machadevrepos/Smart_hydration_Band/Docs/Umbra_Firmware_Overview_and_Status_Report.docx

Umbra Smart Hydration Wristband: Firmware Overview and Status Report

6th Nov 2026

1. Purpose

This report describes how the Umbra wristband firmware (version 1.0.0) works, what it delivers against the project requirements, and what has been tested so far.

2. Platform

- Processor: BMD-350-A-R module (Nordic nRF52832) with Bluetooth Low Energy.
- Software: nRF Connect SDK v3.3.1 (Zephyr RTOS). The firmware is built for the nrf52dk/nrf52832 target with a board overlay that describes the Umbra PCB.
- Sensors: MAX30101 optical sensor for heart rate and BMI270 motion sensor for steps, both on one I2C bus.
- Outputs and input: a vibration motor, a WS2812 RGB status LED and one push button.
- Battery: a LiPo cell; the firmware measures its voltage through a resistor divider.
- Firmware version: 1.0.0, shown at start-up and readable over Bluetooth.

3. Standalone Operation

The band works completely on its own, out of the box, with no app, pairing or setup, according to the requirement. Bluetooth and the app add live data and settings, but the water reminders never depend on them.

- Daily Mode at power-up: white LED, reminder every 90 minutes.
- Night Mode: started and ended by pressing the button on the band. One buzz confirms each press. Green LED, reminder every 35 minutes.
- Reminder pattern: a double tap, two short firm pulses (200 ms on, 200 ms off, 200 ms on).
- LED: solid colour showing the current mode, with no breathing or fading, as the client asked.
- Reminders keep firing whether or not a phone is connected, and even if a sensor fails.

4. Control from the App

The app can control the band over Bluetooth. Every setting below is checked by the band, and values outside the allowed range are rejected.

- Mode: the app can switch between Daily and Night Mode. The band responds exactly as to a button press (LED, one buzz, the interval starts over) and reports every mode change, including those made with the button.
- Reminder intervals: the app can set the Daily and Night intervals from 1 to 240 minutes (the app offers 20, 30, 45 and 60). They are saved in the band's flash memory and kept through power-off. A value of 0 restores the default.
- Quiet hours: Daily Mode reminders are skipped from 23:00 to 07:00 local time. Night Mode always buzzes, because a night out runs through these hours. The app can change the window or turn it off; the setting is kept in flash.
- Time of day: the app sends the time and time zone on each connection. The band needs it for quiet hours and to timestamp its history.
- Buzz command: the app can make the band give its reminder double tap, for example for a test or a demo. At most one command every 2 seconds is accepted.
- Live data: heart rate (standard Bluetooth Heart Rate Service), battery level, step count and mode, plus the firmware version.

The full interface, with every value's byte layout and the sequence the app should follow on each connection, is documented for the app developer in BLE_INTERFACE.md.

5. Sensing

5.1 Heart rate

- The MAX30101 infrared LED is sampled 100 times per second. Infrared is used because the green LED cannot run from the board's 3.3 V LED supply.
- The band detects skin contact from the light level. The first reading comes about 11 seconds after the band is put on, then one reading every second.
- The algorithm filters the signal (0.9–3 Hz), measures the dominant rhythm over the last 8 seconds (40–200 bpm), rejects weak or irregular signals, removes bursts caused by movement, and holds the last value for up to 5 seconds through a short bad stretch. When there is no reliable pulse it reports "no reading" rather than a wrong value.
- The sensor's own sampling clock was found to run about 5% fast, so the firmware measures it and corrects every reading.
- On earlier tests at rest on the wrist it gave steady readings of 82–87 bpm. Accuracy has not yet been measured against a reference device, and arm movement is not compensated.

5.2 Steps

- The BMI270's built-in step counter counts the steps; the firmware reads it once a second. The live count starts from zero at each power-on. Step history is kept in the log (Section 6).

5.3 Battery

- The battery voltage is measured every 10 seconds and converted to a percentage using a typical LiPo curve. The reading has not yet been calibrated against a meter.

6. Data Logging and Sync

Steps and heart rate are stored in the band's flash memory all the time, so nothing is lost while the phone is away, and they are sent to the app automatically when it connects.

- One record per period: 5 minutes in Daily Mode and 1 minute in Night Mode. Each record holds the start time, the steps in the period, the average and highest heart rate, and the mode.
- Capacity: 1024 records, about 3.5 days of Daily Mode or 17 hours of Night Mode. When it is full the oldest record is replaced. The history survives power-off and an empty battery.
- Sync: each record has a number that only increases. On every connection the app asks for everything after the last record it has, receives them, and then an end marker. A dropped connection loses nothing; the next sync starts again from the same point.
- Time stamps: the band has no battery-backed clock. Records made after a power-on but before the app sets the time are given their real time as soon as the time is known, provided the band has not been switched off in between; otherwise they are marked as having no real time.
- The record in progress is saved before the band switches itself off on a flat battery.

7. Reliability Features

- Sensor failures do not stop the band: whether the heart-rate sensor fails at start-up or stops answering later, the reminders, button, LED and Bluetooth keep running. If it stops answering later, heart rate resumes on its own when the sensor recovers; if it fails at start-up, heart rate stays off until the next power-on. If the sensor resets itself, its settings are written back automatically.
- Hardware watchdog: if the firmware ever stops responding for 10 seconds, the band restarts itself instead of staying silent.
- Resume after a restart: after such a restart the band returns to the same mode, the same reminder schedule and the same time of day, so a Night session is not interrupted.
- Bluetooth recovery: if advertising cannot restart after a disconnection, the band retries every 5 seconds, so the app can always reconnect without a power cycle.
- Low-battery protection: below 3.3 V (less than about 5% left) for one minute, the band saves its history, turns off the motor, LED and sensors and switches off, to protect the battery and avoid erratic behaviour. A button press wakes it after charging.
- Diagnostics: at start-up the band reports its firmware version and the reason for the last restart over the debug connection.

8. Power Consumption

- Measured: about 9–10 mA on average, with brief peaks of about 70 mA while the motor runs.
- Estimated battery life: about 25–28 hours on a 300 mAh cell, or about 45 hours on 500 mAh. The motor reminders add less than 0.1% to the average. This meets the 14-hour Daily Mode and 6-hour Night Mode needs.
- Power saving in this version: the processor sleeps between tasks, the band asks the phone for a slow connection interval (200–400 ms), and it switches itself off on a flat battery.
- Possible further savings: measuring heart rate in short bursts in Daily Mode (the client's 5-minute sampling plan), turning the sensor off when the band is not worn, slower Bluetooth advertising, and a dimmer or timed LED. Together these could bring the average to roughly 3–4 mA (estimated). Changing the LED behaviour needs the client's approval.

9. Requirements Coverage

Delivered in this version:

- Standalone reminders with no app or pairing; Daily and Night Mode with the requested defaults.
- Button to start and end a Night session, with a confirming buzz.
- Mode LED (white for Daily, green for Night, solid).
- Double-tap haptic pattern; haptic command from the app.
- Mode and reminder intervals set from the app and stored on the band.
- Quiet hours from 23:00 to 07:00 in Daily Mode.
- Live heart rate, steps and battery level over Bluetooth.
- Steps and heart rate stored in flash while disconnected and synced on reconnection.
- Reminders continue when Bluetooth drops.
- Firmware version reporting, watchdog recovery and low-battery protection.

Not delivered in this version (client agreement needed):

- SpO2, heart rate variability, respiration rate, full PPG waveform capture, skin temperature (no sensor on the board) and sleep detection.

10. Test Status

Confirmed on the prototype:

- The button, both LED colours and the motor patterns, running on battery.
- Average current consumption and motor peak current.
- Heart rate at rest on the wrist and the step counter responding to movement.

Umbra Smart Hydration Wristband
