machadevrepos/Smart_hydration_Band/Docs/AppLandingScreenMockUp.jpeg

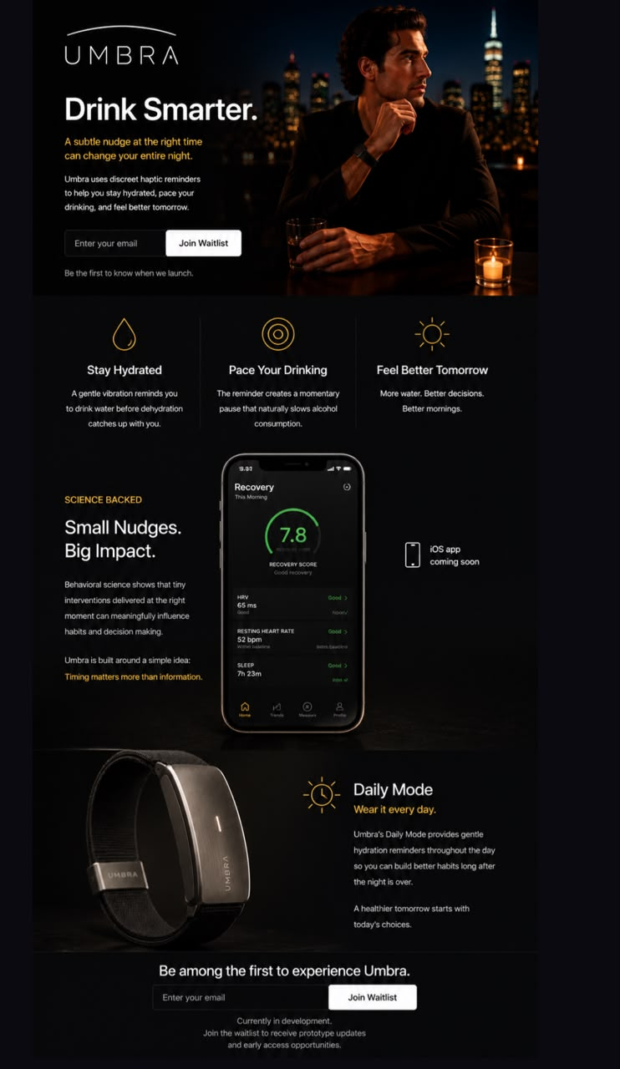
Docs/AppLandingScreenMockUp.jpeg
