machadevrepos/Smart_hydration_Band/Docs/query1ans.jpeg

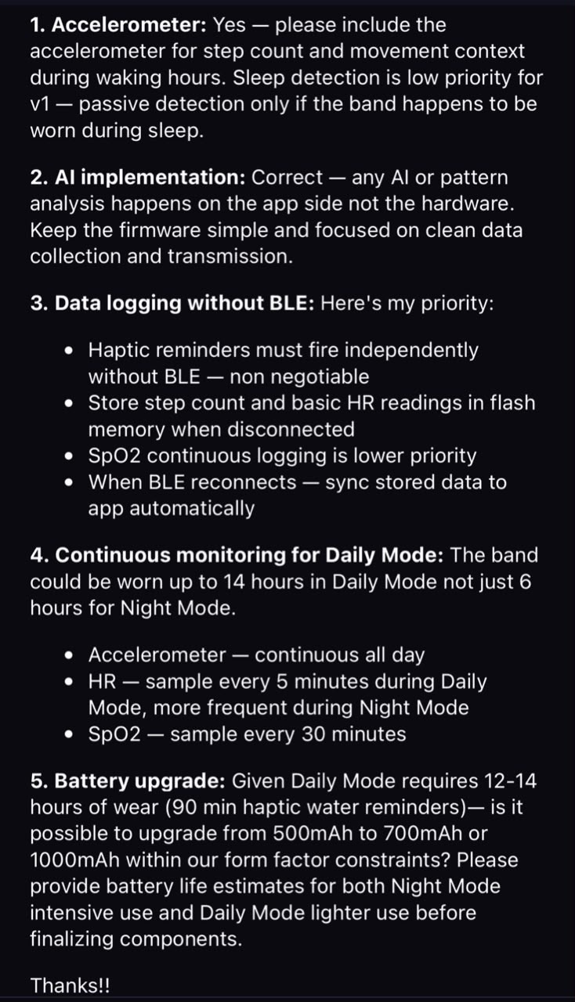
Docs/query1ans.jpeg
