machadevrepos/Smart_hydration_Band/Docs/Query2.jpeg

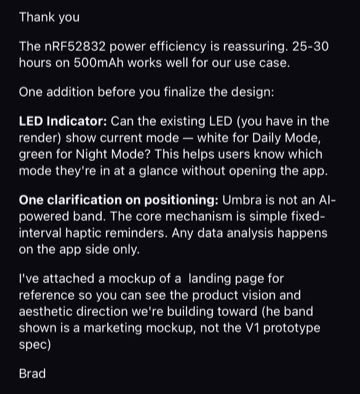
Docs/Query2.jpeg
