machadevrepos/Smart_hydration_Band/Docs/WhatsApp Image 2026-10-29 at 2.35.52 PM.jpeg

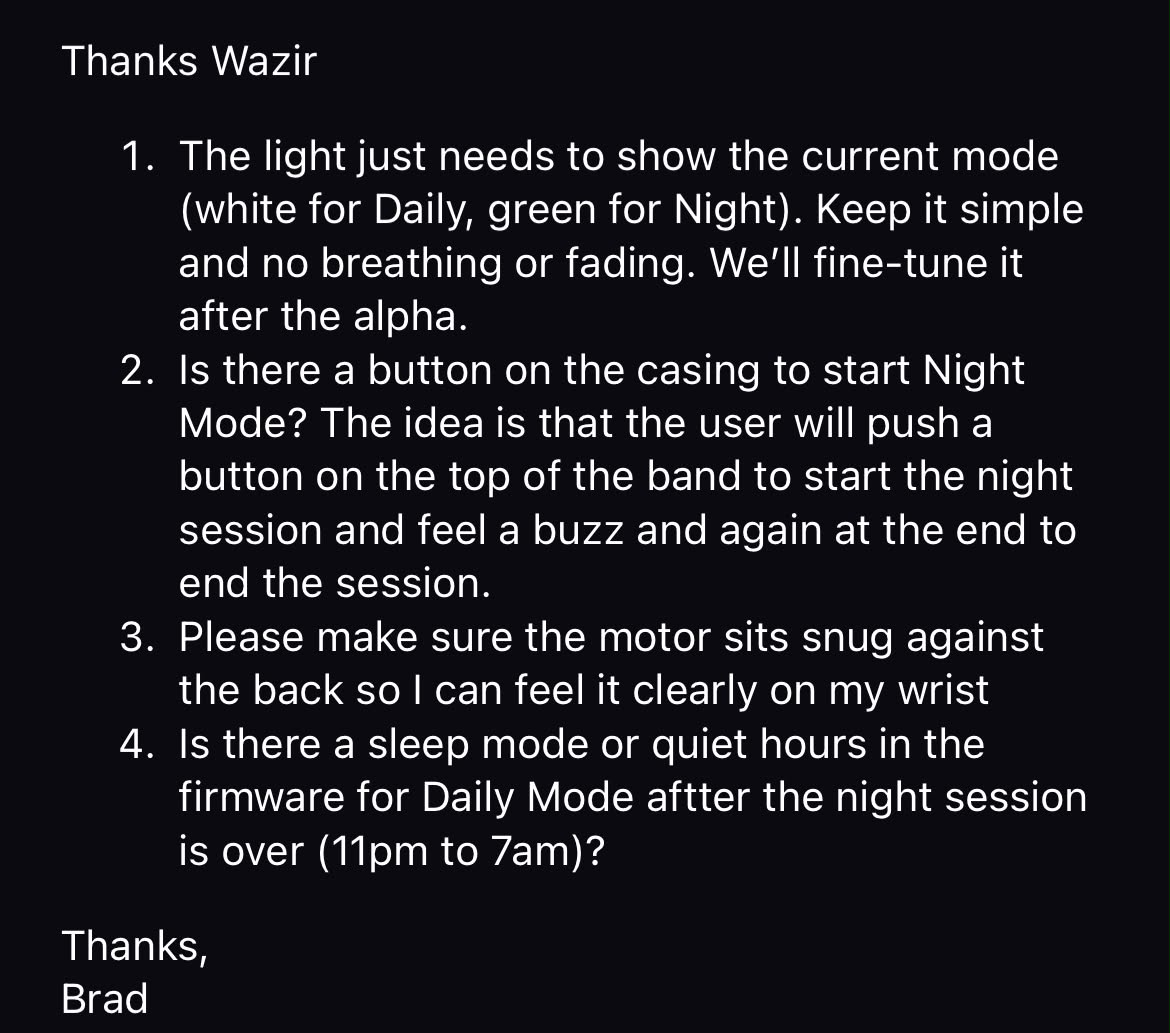
Docs/WhatsApp Image 2026-10-29 at 2.35.52 PM.jpeg
