machadevrepos/Smart_hydration_Band/PCB/kicad_project/project1.step

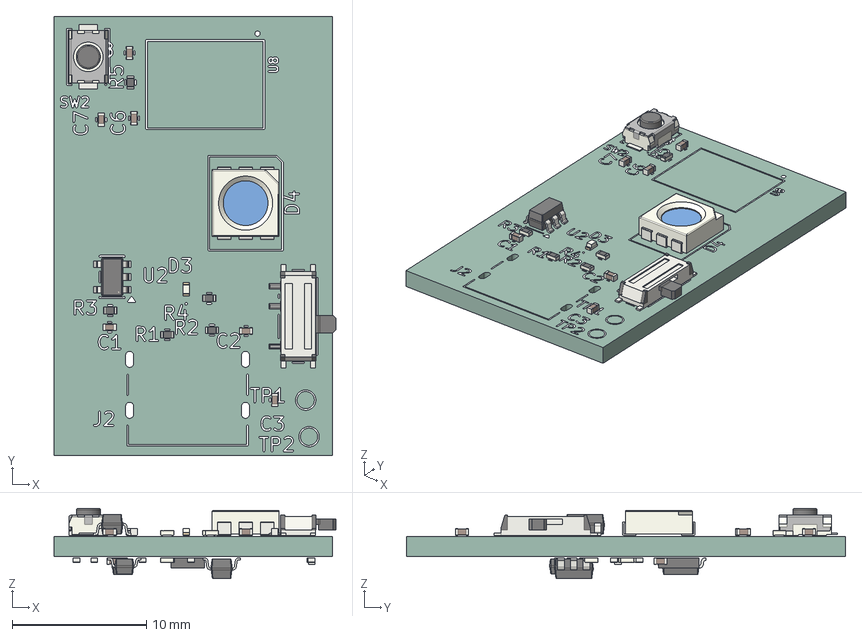
[picture p5: CAD file, 2026-10-29]
PCB/kicad_project/project1.step
21.0 x 32.7 x 5.23 mm
R_0402_1005Metric x 13
C_0402_1005Metric x 8
SOT-23-5 x 2
LED_0402_1005Metric
Fusion_sp
LED_WS2812_PLCC6_50x50mm_P16mm
SW_Push_SPST_NO_Alps_SKRK
D_SOD-123
Bosch_LGA_14_3x25mm_P05mm
SOT-23
proA5D3_silkscreen x 2
proA5D3_PCB
