machadevrepos/Smart_hydration_Band/Docs/Umbra_Hardware_and_Project_Issues_Report.docx

Umbra Smart Hydration Wristband: Hardware and Project Issues Report

6th Nov 2026

1. Purpose

This report records the hardware, PCB and project-level issues found during firmware development, board bring-up and the final pre-delivery review of the Umbra prototype. For each issue it states what was found, why it matters, the recommended fix and its current status, so that the changes made before delivery can be decided with full information.
2. Summary of Priorities

The following items must be resolved, or agreed with the client, before the prototype is shipped:

- MAX30101 supply voltage: the sensor's 1.8 V analog supply is connected to 3.3 V on the schematic. According to the datasheet it should be 1.8V and maximum can be 2.2V.
- Requirements not delivered in this version: SpO2 and several derived metrics need the client's agreement to be deferred.

3. PCB and Hardware Issues

3.1 MAX30101 analog supply above its absolute maximum (Critical)

- Finding: the MAX30101 has a separate 1.8 V analog supply (VDD, pin 11; operating range 1.7–2.0 V, absolute maximum 2.2 V) and an LED supply (VLED+, pins 9–10; 3.1–5.0 V). The schematic connects pin 11 to +3.3 V together with VLED+. The only regulator on the board is the AP2112K-3.3, so there is no 1.8 V rail.
- Impact: 3.3 V is 1.1 V above the absolute maximum. The sensor may work on the bench and then drift, give unreliable readings or fail permanently in use. Firmware cannot detect or correct this. If the sensor fails, the water reminders continue but heart rate is lost.

3.2 Green LED cannot run from the 3.3 V LED supply

- Finding: the MAX30101 green LED needs 4.5–5.5 V on VLED+, while red and IR need 3.1–5.0 V. VLED+ is 3.3 V. On the first board the green channel read about 16,000 counts on a fingertip and 6,000 on the wrist, with no usable pulse.
- Impact: wrist wearables normally use green light because it gives the strongest pulse at the wrist. This board uses the infrared LED instead. Infrared works at rest, but the wrist pulse is small (about 40–70 counts on a level of about 172,000) and depends on how the band sits, which limits heart-rate robustness, especially during movement.

3.3 Supply drop during motor pulses (Major, partly resolved)

- Finding: the board draws a peak of about 70 mA while the motor runs. When the board was powered from the J-Link, the 3.3 V rail dropped during each pulse and the processor reset, so the band restarted in Daily Mode. Powered from the battery, it works correctly.
- Impact: near the end of the battery the regulator has less headroom, and the same drop could reset the band at every reminder.
- Recommended fix: run the band from a bench supply at 3.4–3.5 V and trigger reminders. If it resets, add bulk capacitance near the motor and the regulator, or power the motor from the battery line instead of 3.3 V.

3.4 Status LED powered below its rated voltage (Minor)

- Finding: the WS2812 RGB LED is rated for 3.5–5.3 V and is powered from 3.3 V.
- Impact: it works on this board, but colour and brightness may vary between parts and with temperature.

3.5 Status LED draws current even when off (Minor)

- Finding: the LED's built-in controller is powered permanently from 3.3 V and draws about 1 mA even when dark. When lit white it is the largest single load on the board (about 6 mA, estimated).
- Impact: after the firmware switches the band off on a flat battery, the battery keeps draining slowly. It also shortens battery life in normal use.

3.6 BMI270 CSB pin has no pull-up (Minor)

- Finding: the BMI270 selects I2C or SPI from its CSB pin (P0.23), which has no pull-up on the PCB.
- Impact: the pin floats until the firmware drives it, which could select the wrong interface.

3.7 No low-frequency crystal

- Finding: the BMD-350 module has no 32.768 kHz crystal, so the firmware uses the internal RC oscillator (±500 ppm).
- Impact: the band's clock drifts by up to about 45 seconds per day. This is acceptable because the app sets the time on every connection.

3.7 No skin temperature sensor.

- Finding: the board has no skin temperature sensor, so this requirement cannot be met on the current hardware.
- Status: needs a hardware change if the requirement stays.

4. Project and Requirement Issues

The following client requirements are not delivered in the current firmware, or depend on something outside the band. They need the client's agreement before shipping.

- SpO2: not implemented. It is listed in Milestone 1 (sensors reading heart rate and SpO2). It needs the red LED alongside infrared, and SpO2 measured at the wrist is difficult; accuracy would have to be validated against a reference oximeter. Proposed for the next phase.
- Heart rate variability and respiration rate: not implemented. Both need reliable beat-to-beat timing, which the infrared wrist signal does not yet provide.
- Full PPG waveform capture: not implemented. Streaming the raw 100 samples per second over Bluetooth costs power and needs support in the app.
- Skin temperature: no sensor on the board.
- Sleep detection: not implemented (marked low priority for version 1 by the client).
- Low-power sampling plan: the requested plan (heart rate every 5 minutes in Daily Mode, SpO2 every 30 minutes) is not implemented; heart rate is measured continuously. Battery life still meets the 14-hour need, and the plan can be added later.
- Heart-rate accuracy: readings are steady at rest, but they have not been compared with a reference device (chest strap or ECG), and arm movement is not compensated.
- Quiet hours depend on the phone's time: the band has no battery-backed clock. After a power-on, until the app connects and sets the time, there are no quiet hours and the band buzzes through the night.
- Reminders off the wrist: the band buzzes on schedule even when it is not worn, for example on a nightstand.
- Open Bluetooth link: as required, there is no pairing. Any phone nearby can connect, one at a time, and trigger a buzz; the band accepts at most one buzz command every 2 seconds.
- Live step count restarts at power-on: the step history is kept in the band's flash log and synced to the app.

Umbra Smart Hydration Wristband
