machadevrepos/Smart_hydration_Band/PCB/Schematic.pdf

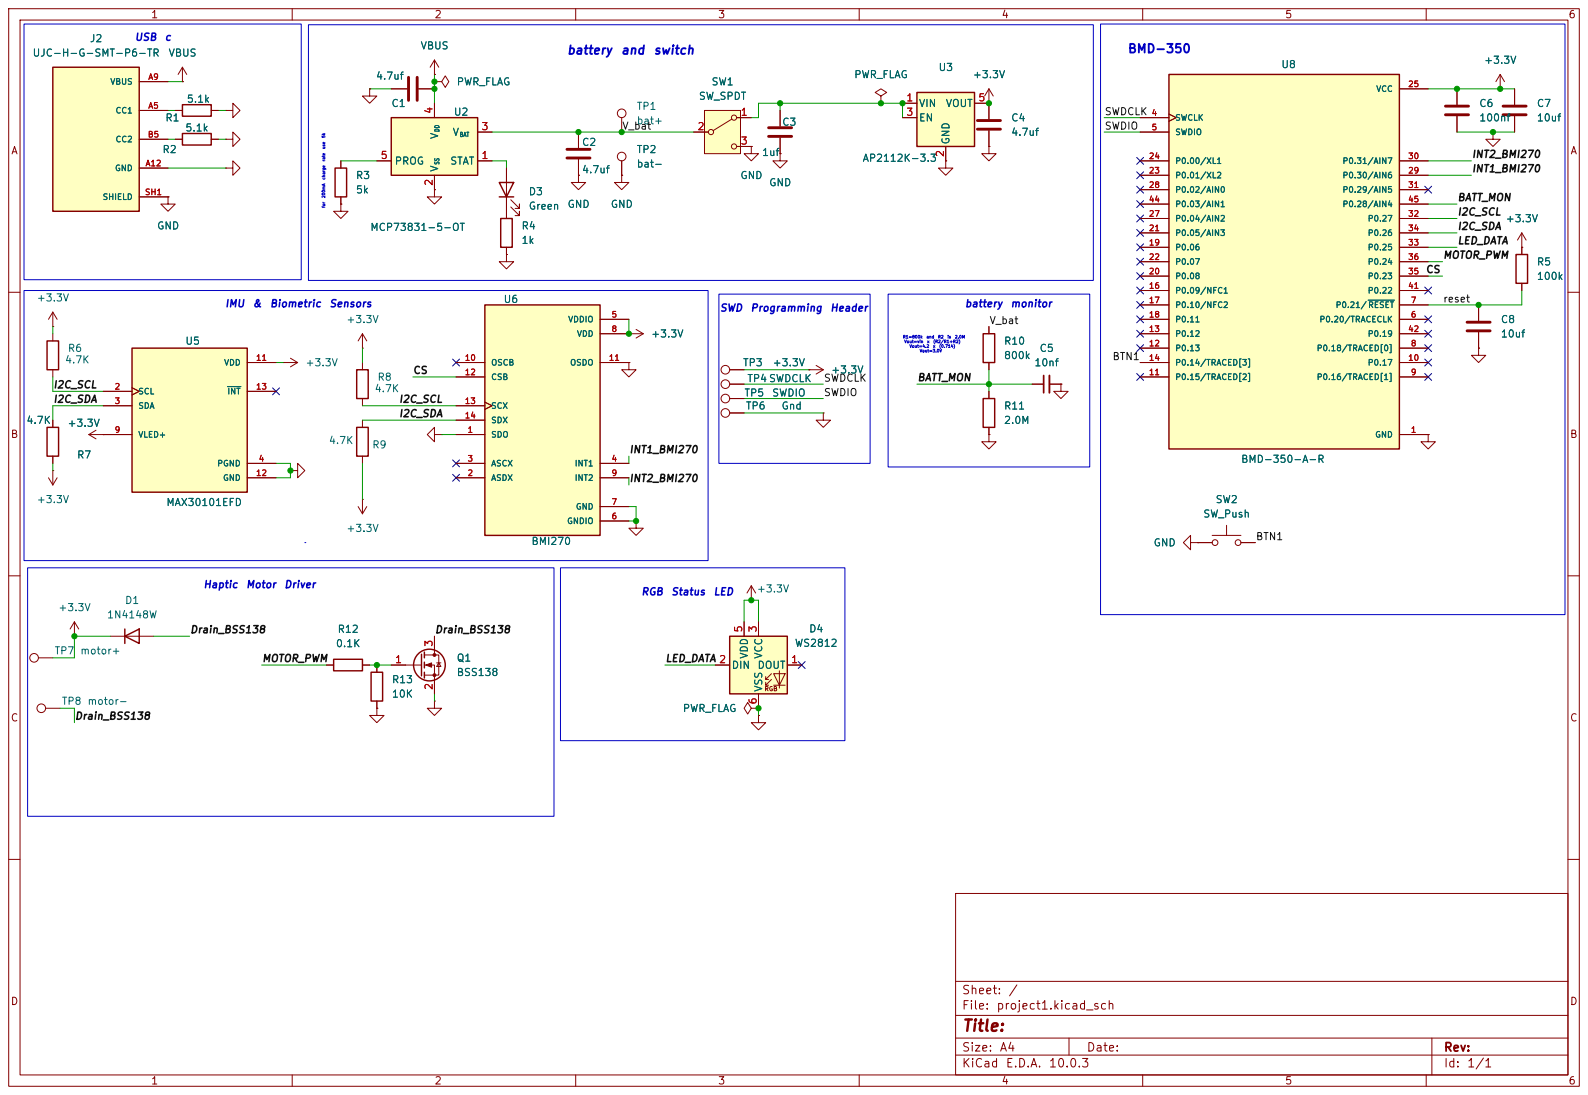
[picture p6: page 1]

Size: A4 | Rev:
KiCad E.D.A. 10.0.3 | Id: 1/1
