machadevrepos/Smart_hydration_Band/PCB/kicad_project/project1.kicad_pcb

## KiCad design PCB/kicad_project/project1.kicad_pcb (2026-10-29)

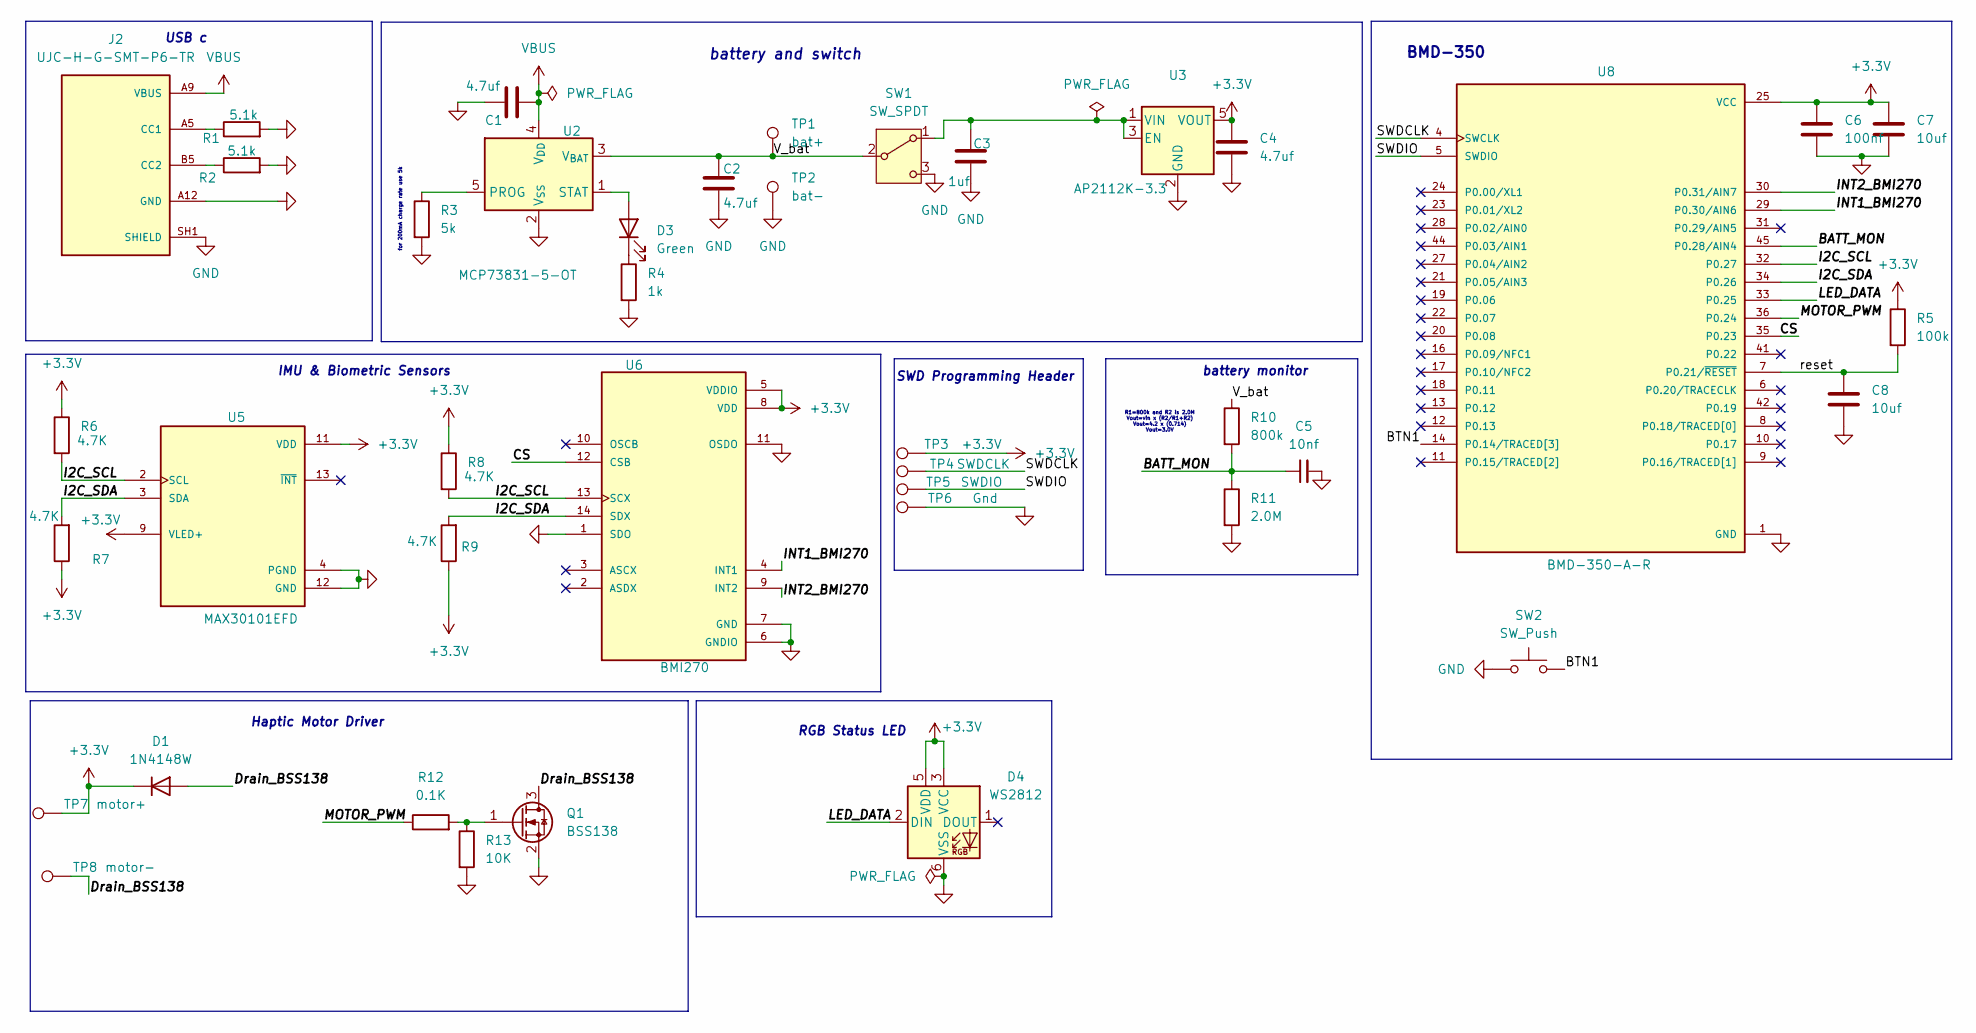
[picture p7: schematic project1.kicad_sch]

Parts:
C1, C2, C4: 4.7uf; C_0402_1005Metric
C3: 1uf; C_0402_1005Metric
C5: 10nf; C_0402_1005Metric
C6: 100nf; C_0402_1005Metric
C7, C8: 10uf; C_0402_1005Metric
D1: 1N4148W; D_SOD-123
D3: Green; LED_0402_1005Metric
D4: WS2812; LED_WS2812_PLCC6_5.0x5.0mm_P1.6mm
J2: UJC-H-G-SMT-P6-TR; SAMESKY_UJC-H-G-SMT-P6-TR; PARTREV 1.0
Q1: BSS138; SOT-23
R1, R2: 5.1k; R_0402_1005Metric
R3: 5k; R_0402_1005Metric
R4: 1k; R_0402_1005Metric
R5: 100k; R_0402_1005Metric
R6, R7, R8, R9: 4.7K; R_0402_1005Metric
R10: 800k; R_0402_1005Metric
R11: 2.0M; R_0402_1005Metric
R12: 0.1K; R_0402_1005Metric
R13: 10K; R_0402_1005Metric
SW1: SW_SPDT; SW_SPDT_PCM12
SW2: SW_Push; SW_Push_SPST_NO_Alps_SKRK
TP1: bat+; TestPoint_Pad_D1.0mm
TP2: bat-; TestPoint_Pad_D1.0mm
TP3: +3.3V; TestPoint_Pad_D1.0mm
TP4: SWDCLK; TestPoint_Pad_D1.0mm
TP5: SWDIO; TestPoint_Pad_D1.0mm
TP6: Gnd; TestPoint_Pad_D1.0mm
TP7: motor+; TestPoint_Pad_D1.0mm
TP8: motor-; TestPoint_Pad_D1.0mm
U2: MCP73831-5-OT; SOT-23-5
U3: AP2112K-3.3; SOT-23-5
U5: MAX30101EFD; Maxim_OLGA-14_3.3x5.6mm_P0.8mm; PARTREV 2
U6: BMI270; Bosch_LGA-14_3x2.5mm_P0.5mm
U8: BMD-350-A-R; XCVR_BMD-350-A-R; PARTREV 2.0

Connections:
+3.3V: C4.1, C6.1, C7.1, D1.1 (K), D4.3 (VCC), D4.5 (VDD), R5.1, R6.1, R7.1, R8.1, R9.1, TP3.1 (1_1), TP7.1 (1_1), U3.5 (VOUT), U5.9 (VLED+), U5.10 (VLED+), U5.11 (VDD), U6.5 (VDDIO), U6.8 (VDD), U8.25 (VCC)
/BATT_MON: C5.1, R10.2, R11.1, U8.45 (P0.28/AIN4)
/BTN1: SW2.2, U8.14 (P0.14/TRACED[3])
/CS: U6.12 (CSB), U8.35 (P0.23)
/Drain_BSS138: D1.2 (A), Q1.3 (D), TP8.1 (1_1)
/I2C_SCL: R6.2, R8.2, U5.2 (SCL), U6.13 (SCX), U8.32 (P0.27)
/I2C_SDA: R7.2, R9.2, U5.3 (SDA), U6.14 (SDX), U8.34 (P0.26)
/INT1_BMI270: U6.4 (INT1), U8.29 (P0.30/AIN6)
/INT2_BMI270: U6.9 (INT2), U8.30 (P0.31/AIN7)
/LED_DATA: D4.2 (DIN), U8.33 (P0.25)
/MOTOR_PWM: R12.1, U8.36 (P0.24)
/SWDCLK: TP4.1 (1_1), U8.4 (SWCLK)
/SWDIO: TP5.1 (1_1), U8.5 (SWDIO)
/V_bat: C2.1, R10.1, SW1.2 (B), TP1.1 (1_1), U2.3 (V_{BAT})
/reset: C8.1, R5.2, U8.7 (P0.21/~RESET)
GND: C1.1, C2.2, C3.2, C4.2, C5.2, C6.2, C7.2, C8.2, D4.6 (VSS), J2.A12 (GND), J2.B12 (GND), J2.SH1 (SHIELD), J2.SH2 (SHIELD), J2.SH3 (SHIELD), J2.SH4 (SHIELD), Q1.2 (S), R1.2, R2.2, R3.2, R4.2, R11.2, R13.2, SW1.3 (C), SW2.1, TP2.1 (1_1), TP6.1 (1_1), U2.2 (V_{SS}), U3.2 (GND), U5.4 (PGND), U5.12 (GND), U6.1 (SDO), U6.6 (GNDIO), U6.7 (GND), U6.11 (OSDO), U8.1 (GND), U8.2 (GND), U8.3 (GND), U8.15 (GND), U8.26 (GND), U8.37 (GND), U8.38 (GND), U8.39 (GND), U8.40 (GND), U8.43 (GND), U8.46 (GND), U8.47 (GND)
unnamed: D3.2 (A), U2.1 (STAT)
unnamed: D3.1 (K), R4.1
unnamed: J2.A5 (CC1), R1.1
unnamed: J2.B5 (CC2), R2.1
unnamed: Q1.1 (G), R12.2, R13.1
unnamed: C3.1, SW1.1 (A), U3.1 (VIN), U3.3 (EN)
unnamed: R3.1, U2.5 (PROG)
VBUS: C1.2, J2.A9 (VBUS), J2.B9 (VBUS), U2.4 (V_{DD})

Notes on the sheet:
USB c
RGB Status LED
battery monitor
SWD Programming Header
IMU & Biometric Sensors
R1=800k and R2 is 2.0M Vout=vin x (R2/R1+R2) Vout=4.2 x (0.714) Vout=3.0V
for 200mA charge rate use 5k
BMD-350
battery and switch
Haptic Motor Driver

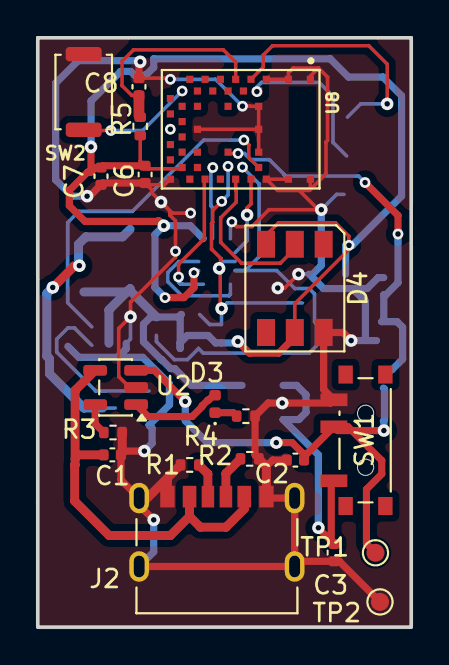
[picture p8: board project1.kicad_pcb from above]

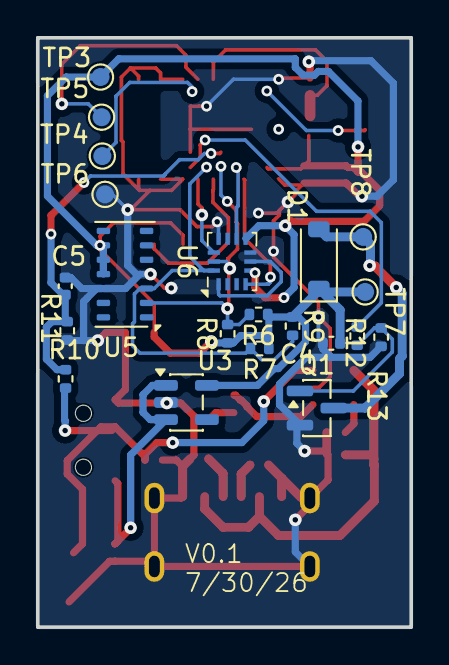
[picture p9: board project1.kicad_pcb from below]

Board: 2 copper layers, 20.7 x 32.7 mm, 41 parts (21 on the bottom side), 24 nets.
