machadevrepos/Smart_hydration_Band/(commit log)

2026-10-29 Initial commit: project organization (Firmware, PCB, Docs)
    [project1.kicad_pcb, project1.kicad_sch, project1.step]
2026-10-30 Firmware: MAX30101 heart rate on nRF52832
    Bring up the MAX30101 on the BMD-350 (nRF52832) and report heart rate over
    RTT once per second.
    - Devicetree overlay for the NCS v3.3.1 MAX30101 driver: multi-LED mode with
    red/IR/green slots, 100 Hz, 18-bit (411 us), LED current 0x60. Build-time
    checks guard the settings the estimator depends on.
    - Sensor wrapper reads the FIFO write/read pointers and overflow counter
    before fetching, so only new samples are returned and gaps are detected.
    - Windowed autocorrelation estimator: 0.5-4 Hz band-pass, first difference,
    8 s window every second on red, IR and green, best channel by quality,
    rate tracking, half-rate correction, median of 3.
    - Sam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
    [app_config.h, heart_rate.c, heart_rate.h, main.c, max30101.c, max30101.h]
2026-10-30 Docs: add MAX30101 reference driver and heart-rate design notes
    Docs/MAX30101 is a copy of the older Kconfig-based Zephyr MAX30101 driver,
    kept for reference; NCS v3.3.1 ships a newer devicetree-based driver, which
    the firmware uses.
2026-10-30 Ignore KiCad lock files
2026-10-30 Firmware: clean up heart-rate RTT output
    Replace the Zephyr log lines for heart rate with a plain table printed on a
    fixed 1 s timer: time, rate and a status (no skin contact, measuring with a
    countdown, signal good/fair/weak with the quality, holding last value, no
    clear pulse). Off the skin the status is printed once and then every 10 s.
    The per-channel diagnostics line moves behind APP_PPG_DIAGNOSTICS (off by
    default). Warnings and errors stay on the Zephyr logger.
    [app_config.h, heart_rate.c, heart_rate.h, main.c, max30101.c]
2026-11-04 Firmware: tune wrist heart rate from a raw capture
    Replaying a raw wrist recording (Docs/Raw_logs.md) showed a clear 1.4 Hz IR
    pulse that the estimator was losing: the pulse is nearly a sine, so first
    differencing only boosted noise, and slow lines at 0.2-0.7 Hz caused locks on
    half the rate.
    - Band-pass 0.9-3 Hz with no difference step.
    - Pick the shortest lag with a peak within 90% of the best, take half the lag
    only at 80% or more, and require a distant rate to persist before showing it.
    This fixes 66 bpm reading as 138 on a finger.
    - Zero 1 s motion bursts and reject windows still settling after placement.
    - IR LED 38 mA with a 62.5 pA/LSB ADC range; quality shown when no reading.
    -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
    [app_config.h, heart_rate.c, heart_rate.h, main.c]
2026-11-04 Firmware: enable the BMI270 built-in step counter
    Load Bosch's BMI270 firmware, enable the on-chip step counter and read the
    count once a second. Counting is done entirely by the chip.
    The module talks to the BMI270 over I2C directly with CONFIG_BMI270=n, because
    Zephyr's driver loads the firmware in 256-byte writes that the nRF52832's I2C
    cannot send, and has no step-counter API. The firmware goes in 128-byte chunks
    from RAM. P0.23 (CSB, no pull-up on the PCB) is held high by a GPIO hog.
    Adds a steps column to the RTT table. If the BMI270 fails to start, an error is
    logged, steps show "--" and heart rate keeps running.
    On the board: the chip starts and counts when the PCB is moved, and h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
    [main.c, step_counter.c, step_counter.h]
2026-11-04 Firmware: bring up the WS2812 status LED and push button
    Drive the WS2812 with Zephyr's SPI driver on SPIM2: data on P0.25 and clock on
    P0.22, which is unconnected on the PCB but needed because the SPIM stalls
    without a clock pin. The button is SW2 on P0.14 with the internal pull-up, polled
    in the main loop with a debounce.
    Bring-up behavior: white at power-up, and each press swaps white and green. Every
    press prints its time, number and result over RTT.
    Reported working on the PCB.
    [app_config.h, button.c, button.h, main.c, status_led.c, status_led.h]
2026-11-04 Firmware: add haptics and band modes, remove test code
    Add the client's standalone behavior:
    - Daily Mode at power-up (white LED, double tap every 90 min) and Night Mode
    (green LED, double tap every 35 min).
    - A button press switches mode, gives one buzz and restarts the interval.
    - Motor patterns run on the system work queue because the main loop must keep
    draining the sensor FIFO.
    Remove test code and unused resources:
    - Raw PPG stream, diagnostics line and vibration presets.
    - Red and green sensor channels: the MAX30101 now pulses only IR and the
    estimator processes one channel. Green cannot work from the 3.3 V LED supply,
    and red returns when SpO2 is added.
    - UART driver, enlarg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
    [app_config.h, band_mode.c, band_mode.h, button.c, button.h, haptic.c, haptic.h, heart_rate.c]
2026-11-06 Firmware: add BLE services and battery reporting
    Advertise as "Umbra" with no pairing; the band behaves the same with or without
    a connection:
    - Heart Rate Service, notified with each reading.
    - Battery Service from the battery divider on P0.28, measured every 10 s with a
    typical LiPo curve (not calibrated).
    - Umbra service: steps and mode (read, notify) and a haptic write that fires
    the double tap.
    - Nordic UART JSON line once a second, and "trigger_haptic", for the current
    app until it uses the services above.
    Haptic patterns can now start from the main loop and from BLE commands, so
    starting one is serialized.
    Not yet confirmed on the board.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
2026-11-06 Firmware: keep reminders running when the MAX30101 fails to start
    main() returned when max30101_init() failed, before the mode, LED, button and
    BLE were set up, so a missing or faulty heart-rate sensor left the band with no
    LED, no reminders and no BLE. The client requires the reminders to work on their
    own.
    A failed MAX30101 is now handled like a failed BMI270: the error is logged, the
    FIFO is never read, the status line shows "heart-rate sensor unavailable", no
    heart rate is sent and everything else runs.
    Not built or run on the board.
    [main.c]
2026-11-06 Firmware: keep reminders running when MAX30101 reads fail
    A failed FIFO read ended the loop iteration with "continue", which skipped the
    button, the reminder check, the battery and the BLE telemetry. A sensor that
    stopped answering after start-up (loose connection, I2C fault, brown-out)
    silently stopped every reminder while the LED stayed on.
    Sensor polling now lives in poll_heart_rate(), which only returns on error, so
    the rest of the loop always runs. While reads fail, contact is dropped so no
    stale heart rate is sent and the status line shows "heart-rate sensor not
    responding". The first failure and the recovery are each logged once instead
    of every 40 ms. On recovery the rate meter rest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
    [main.c]
2026-11-06 Firmware: reset on a hang with the hardware watchdog
    Nothing recovered the band from a hung thread or a stuck bus: it would sit with
    the LED on and never buzz again. The client's core requirement is that the
    reminders keep firing.
    The nRF52832 watchdog now resets the chip after 10 s without a feed. main()
    starts it first and feeds it on every loop pass, but only while the system work
    queue (motor patterns, Bluetooth host) has checked in within 5 s, so a stall in
    either one resets the band. A fatal error that halts the CPU ends the same way.
    It pauses while a debugger halts the CPU.
    The reset reason is printed over RTT at start-up ("last reset: watchdog") so
    soak tests show whether a reset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
    [main.c, watchdog.c, watchdog.h]
2026-11-06 Docs: make the MAX30101 VDD supply a delivery check
    The schematic ties the MAX30101's 1.8 V VDD (pin 11, absolute maximum 2.2 V)
    to +3.3 V, and its only regulator is the AP2112K-3.3, so there is no 1.8 V
    rail. This is a hardware fault that firmware cannot detect or correct.
    The README now marks it as a delivery blocker until the unit is checked, with
    the measurement to make on pin 11, the rework if it reads 3.3 V (a 1.8 V LDO
    for VDD only, 1 uF at the pin, VLED+ unchanged), and the schematic change for
    later units.
2026-11-06 Firmware: resume mode and reminder schedule after a reset
    With the watchdog, a reset is now the recovery path, but every reset started
    over in Daily Mode with a full 90 min wait. A Night session silently dropped to
    90 min reminders, and a band that kept resetting more often than its interval
    would never buzz.
    band_mode.c keeps the mode and the time to the next reminder in no-init RAM,
    each value next to its bitwise inverse, and refreshes it every loop pass. After
    a reset that keeps RAM (watchdog, CPU lockup, fatal error or software reset,
    debugger) the band resumes the same mode and schedule and the start-up line
    says "(resumed after reset)". Power-on, brown-out and wake from system off
    sta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
    [band_mode.c, band_mode.h, main.c, watchdog.c, watchdog.h]
2026-11-06 Firmware: retry BLE advertising until it starts
    Advertising was started once at boot and once after each disconnect. If either
    call failed, nothing tried again and the app could not reach the band until it
    was power-cycled; a failure at boot also disabled BLE entirely.
    The BLE thread now starts advertising, and while it is down retries every 5 s
    (the semaphore wait times out to drive this). -EALREADY counts as running.
    Retries pause while a phone is connected, since only one connection is
    allowed. The failure is logged once per run, not on every retry.
    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
    [ble_service.c]
2026-11-06 Firmware: report the firmware version at start-up and over BLE
    Nothing on the band said which build it was running, so a unit in the field
    could not be matched to its source.
    The version is set once, CONFIG_BT_DIS_FW_REV_STR in prj.conf, starting at
    1.0.0. It is printed in the RTT header and served by the BLE Device
    Information Service as the Firmware Revision String (0x2A26), which any BLE
    scanner app can read.
    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
2026-11-06 Firmware: send heart_rate 0 when there is no reading
    The JSON line left heart_rate out when there was no reading, and the app keeps
    the last value it received, so after the band came off the wrist the app showed
    the old heart rate indefinitely.
    heart_rate is now in every line, with 0 meaning no reading (off the wrist,
    settling, sensor fault). The README states the contract: the app must show 0
    as "no reading", not "0 bpm". Until the app does, it will show "0 bpm" instead
    of a stale value.
    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
2026-11-06 Firmware: switch off on a flat battery
    Nothing reacted to a flat battery: the band ran down until brown-out resets,
    with erratic LED and motor behavior, and the LiPo was left deeply discharged.
    After six readings in a row (one minute, so motor dips never count) below
    3.3 V, the band stops the motor, turns the LED off, puts the MAX30101 and
    BMI270 into shutdown and enters nRF52 system off. A button press wakes it as a
    fresh start; if the battery is still flat it switches off again a minute later.
    Readings under 2.5 V are treated as a measurement fault so a broken divider
    cannot keep the band off.
    Adds haptic_stop(), STATUS_LED_OFF, max30101_shutdown(),
    step_counter_shutdown() and button_ena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
    [app_config.h, button.c, button.h, haptic.c, haptic.h, main.c, max30101.c, max30101.h]
2026-11-06 Firmware: restore the MAX30101 settings if it stops sampling
    If the sensor reset itself, for example on a supply dip, it kept answering on
    I2C but lost the settings the driver wrote at boot and stopped sampling. Reads
    succeeded with no data, so heart rate disappeared until a power cycle and
    nothing was logged.
    max30101_init() now reads those settings back once (FIFO, mode, SpO2 config,
    LED currents, slots), so the driver stays their only source.
    max30101_restore() writes them again, empties the FIFO and restarts sampling.
    The main loop calls it when reads succeed but no sample has arrived for 1 s,
    retrying each second until samples return, logged once. Contact and the
    estimator then start o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
    [main.c, max30101.c, max30101.h]
2026-11-06 Firmware: rate-limit BLE haptic commands
    With no pairing, any phone in range can connect and write the haptic command
    as fast as it likes, and a stuck app could do the same, buzzing the band
    nonstop.
    Commands from either path (GATT write or NUS "trigger_haptic") are now ignored
    if they come under 2 s after the last one fired, with a log line. The write
    still succeeds so the app sees no error. Reminders and button buzzes are not
    affected.
    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
    [ble_service.c]
2026-11-06 Firmware: let the app set the mode and reminder intervals
    The client requires the mode and the reminder intervals to be adjustable from
    the app; until now only the button changed the mode and the intervals were
    compile-time constants.
    - Mode characteristic (1ab10002) is now writable: 0 Daily, 1 Night. The main
    loop applies it like a button press (LED, buzz, interval restart).
    - New Intervals characteristic (1ab10004), read/write: Daily then Night
    minutes, uint16 LE each, 1-240 (the app offers 20/30/45/60), 0 restores the
    default (90/35). A new interval for the current mode restarts its wait.
    - The intervals are saved in flash and loaded at start-up, through a new
    storage module (Zep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
    [app_config.h, band_mode.c, band_mode.h, ble_service.c, main.c, storage.c, storage.h]
2026-11-06 Firmware: add quiet hours from 23:00 to 07:00 using the app's clock
    The client asked for no reminders overnight in Daily Mode (11pm to 7am). The
    band has no battery-backed clock, so it now takes the time from the app.
    - New Time characteristic (1ab10005), read/write: UTC seconds (uint32 LE) and
    the local offset from UTC in minutes (int16 LE). wall_clock.c runs it from
    the nRF52 clock and keeps it through a watchdog or software reset, in
    no-init RAM like the mode. Times before 2024 are rejected.
    - New Quiet hours characteristic (1ab10006), read/write: start and end in
    local minutes after midnight, default 23:00-07:00, equal values turn them
    off. Kept in flash.
    - A Daily Mode remind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
    [app_config.h, band_mode.c, band_mode.h, ble_service.c, main.c, wall_clock.c, wall_clock.h]
2026-11-06 Firmware: log steps and heart rate to flash and sync them to the app
    The client asked for step count and heart rate to be stored in flash while
    no app is connected, and synced automatically when it reconnects.
    - data_log.c closes one 16-byte record per period, 5 min in Daily Mode and
    1 min in Night Mode (a mode change closes it early): start time, steps, mean
    and peak heart rate, mode, boot number. Logging runs all the time, so a
    phone that is connected but not listening loses nothing either.
    - Records go into a ring of 1024 slots in the settings NVS, under IDs below
    the range settings uses; the oldest is overwritten when full. A sequence
    number that only grows is recovered from f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
2026-11-06 Docs: add the BLE interface for the app developer
    BLE_INTERFACE.md is the contract between the firmware and the app: how to find
    the band, every service and characteristic with its exact byte layout, value
    ranges and ATT errors, what the band does on each write, the sequence to follow
    on every connection (time, subscriptions, reads, log sync with the end marker),
    how to read the log records, Dart encode/decode examples, the changes the
    current app needs, and a behavior summary.
2026-11-06 Docs: add the hardware issues and firmware status reports
    Two reports for the client, built from the engineering document template:
    - Umbra_Hardware_and_Project_Issues_Report.docx: the PCB and hardware issues
    found during bring-up and the final review (finding, impact, recommended fix
    and status for each), the client requirements not delivered in this
    version, the checks still needed before shipping, and the minimum changes
    for this delivery and the next PCB revision.
    - Umbra_Firmware_Overview_and_Status_Report.docx: how firmware 1.0.0 works
    (standalone operation, app control, sensing, data log and sync, reliability
    features, power), requirements coverage and test status.
    Co-Au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
2026-11-06 Firmware: sample the MAX30101 red channel alongside IR
    First step towards SpO2, which needs red and infrared taken together.
    - The overlay now uses LED slots <1 2 0 0>: red in slot 1, IR in slot 2, both
    at 100 Hz. The red current starts at 0, so the red LED stays dark and costs
    nothing until an SpO2 measurement turns it on.
    - max30101_read_fifo() returns both channels per sample (struct
    max30101_sample); the driver already reads all active slots in one I2C
    transfer.
    - New max30101_set_red_current() sets the red LED current (0.2 mA per step).
    - Build-time checks now require this slot layout and the red LED off at boot.
    Heart rate and skin contact still use IR only and are unchanged.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
2026-11-06 Firmware: read the BMI270 acceleration
    SpO2 is only accurate with the wrist still, so the measurement needs to see
    movement, not just the step count.
    step_counter_read_accel() reads the three axes from the BMI270 data registers
    in one burst. The range stays at its reset value of +-8 g
    (STEP_COUNTER_ACCEL_PER_G = 4096 counts per g). The step counter is unchanged.
    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
    [step_counter.c, step_counter.h]
2026-11-06 Firmware: measure SpO2 in spot checks with per-window diagnostics
    Adds the client's SpO2 requirement as periodic spot checks, the way wrist
    devices do it: continuous SpO2 at the wrist is unreliable with movement.
    src/spo2.c, about 35 s per measurement:
    - Lights the red LED and adjusts its current so the red level sits near
    120000 counts (up to three steps), then lets the filters settle for 2 s.
    - Measures seven 4 s windows: DC as the mean, AC as the RMS after the same
    0.9-3 Hz band-pass as heart rate, R = (red AC/DC) / (IR AC/DC).
    - Rejects a window with more than 100 mg of movement (BMI270), a DC level out
    of range or a perfusion index under 30 ppm, or red and IR pulses that do
    not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
2026-11-06 Firmware: report SpO2 over BLE, in the JSON line and in the data log
    - New SpO2 characteristic (1ab10009), read/write/notify, 10 bytes: status of
    the latest attempt, the last valid SpO2 and its quality, the UTC time of
    that reading, and the latest attempt's R x 1000 (for calibration). Writing
    1 asks for a measurement now; the result is notified about 35 s later.
    Notified whenever the status or the reading changes.
    - The NUS JSON line always carries "spo2": the last reading while it is
    recent (up to 35 min old), 0 otherwise. The current app already parses this
    field.
    - Data log format version 2: records grow from 16 to 20 bytes with the SpO2
    reading taken in that period and its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
2026-11-06 Docs: document SpO2 and its calibration; firmware 1.1.0
    - README: a SpO2 section (when it measures, how, the window checks, the RTT
    output, the wrist-signal risk) and the calibration procedure against a
    fingertip oximeter; the BLE table, data log and scope updated.
    - BLE_INTERFACE.md: the SpO2 characteristic with its status codes and a
    "measure now" write, "spo2" in the JSON line, log format version 2 (20-byte
    records with SpO2), Dart decoding by the record length from Log control, and
    the SpO2 items for the app.
    - Firmware version 1.1.0, since the log format and the flash layout changed.
2026-11-06 Firmware: fix broken printk strings in the SpO2 output
    The three SpO2 result lines in run_spo2() had their "\n" turned into real
    line breaks when they were inserted, which split the string literals and broke
    the build. Restored the escapes; a scan of all sources found no other broken
    string literals.
    [main.c]
2026-11-06 Firmware: add an SpO2 bench mode for fast back-to-back measurements
    Testing and calibration need many SpO2 readings, and the delivery schedule
    (first after 2 min, then every 30 min, retry after 5 min) gives one only now
    and then.
    - The SpO2 timing is now in seconds (APP_SPO2_FIRST_S, _INTERVAL_S,
    _RETRY_S, and _WAIT_S for a check that finds no contact or no pulse yet).
    - APP_SPO2_BENCH_MODE switches to: first check as soon as the heart rate
    locks, 10 s between checks, 2 s between contact/pulse checks; about one
    reading every 45 s while seated.
    - While it is on, the build prints a #warning and the band prints "SpO2 BENCH
    MODE" at start-up, so it is not shipped by accident.
    Bench mod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
2026-11-06 Firmware: accept SpO2 windows within 20% of the median R
    The first wrist measurement on the board had all seven windows good (red
    perfusion 54-96 ppm, IR 151-192 ppm, correlation 91-96%, movement under
    30 mg), but R drifted from 0.51 to 0.36 across them, so only three were
    within 10% of the median (0.44) and the result was "unstable". At 20%, six of
    the seven agree.
    - AGREE_FRACTION 0.10 -> 0.20.
    - A summary line per measurement: good windows, how many agree, median R and
    the spread (max - min over median), for calibration notes and to watch the
    drift.
    - The red LED current found by the adjustment is reused by the next attempt,
    successful or not, so back-to-back checks skip most of th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
    [spo2.c]
2026-11-06 Firmware: keep the boot output in RTT
    The start-up lines (firmware version, reset reason, time of day, mode) and the
    end of the Bluetooth start-up log were missing on the board: the 1 KB RTT
    buffer overflowed before the viewer read it, and the dropped coloured log line
    left "0m [0m" fragments. Two boots in a row showed no reset reason because of
    this.
    - RTT up buffer 1 KB -> 4 KB (3 KB more RAM).
    - Log colours off.
    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
2026-11-10 Firmware: stop doomed SpO2 measurements early, report 80-100% only
    Two production safeguards for the SpO2 spot check:
    - A measurement now ends as soon as enough windows are rejected that four
    good ones are no longer possible (for example a wrist that keeps moving),
    instead of always running all seven windows with the red LED on.
    - A result under 80% is treated as an unstable signal and retried, not
    reported. At rest a wrist reading that low is far more likely a bad signal
    than real, and showing it would alarm the wearer. The reported range was
    70-100%.
    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
    [spo2.c]
2026-11-10 Firmware: turn SpO2 bench mode off for delivery
    Back to the delivery schedule: the first check about 2 min after power-up,
    then every 30 min while worn, 5 min after a failed attempt. The red LED is
    lit only during a check (about 35 s), so the bench mode's battery cost is gone.
    The SpO2 formula stays the textbook 110 - 25 R. On the prototype at rest it
    gave R 0.44-0.48, so 98-99%, consistent across measurements and plausible;
    the agreed target for this version is an estimate of that quality. The
    README and app_config.h say so, and that a check against a reference
    oximeter is still to do.
    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
    [app_config.h]
2026-11-10 Firmware: make SpO2 hold up on a loosely worn band
    Follow the open-source RF algorithm for the MAX3010x (Fraczkiewicz,
    MAX30102_by_RF) and Maxim's published calibration curve, with changes
    for a band that sits loosely on the wrist:
    - R per window from a least-squares fit of red against IR instead of
    the RMS ratio, so noise in the weaker red channel no longer raises R
    and pulls SpO2 down as the fit loosens. The RMS ratio is still
    printed for comparison.
    - Red/IR correlation threshold 0.70 per window (RF uses 0.8 on a
    fingertip), perfusion floor 20 ppm, valid R 0.02-1.84 as in RF.
    - Windows run until six are good or twelve are measured, giving a loose
    fit more chances. Measurement s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
    [app_config.h, ble_service.c, main.c, spo2.c, spo2.h]
2026-11-10 Firmware: reject SpO2 windows without a clear pulse
    Add the RF algorithm's second check: the IR signal must repeat at the
    pulse rate (RF's autocorrelation ratio). The heart-rate estimator already
    computes this every second as its quality, so each SpO2 window now needs a
    mean heart-rate quality of 65 or more.
    A wrist test showed why. With the band shifting on the skin, red and IR
    swung together (correlation 80-87%, R near 1, read as 85%) while the
    accelerometer saw only 17-37 mg and the heart rate showed "no clear
    pulse". Those windows produced a false 85%; they are now rejected, and
    the attempt is retried after "too much movement".
    Each window line prints the pulse quality, and the failure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
    [main.c, spo2.c, spo2.h]
2026-11-10 Firmware: print the build time at start-up
    Two wrist tests ran an image built days before the SpO2 changes, and
    nothing in the output showed it. The banner now prints the build date
    and time and the SpO2 method, so a stale image is obvious at once.
2026-11-10 Firmware: use Maxim's MAX30101 SpO2 calibration
    The RD117 curve (-45.060 R^2 + 30.354 R + 94.845, from Maxim's MAX30102
    reference code) peaks at R 0.34 and stays at 99-100% up to R 0.47. On
    the wrist with a clean signal (red/IR correlation 97-99%) the band reads
    R 0.41-0.49, so both bench measurements showed 100%.
    Switch to the calibration Maxim publishes for the MAX30101 (the default
    coefficients of its MAX32664 sensor-hub firmware):
    1.5958422 R^2 - 34.659664 R + 112.68987. It falls steadily over the
    band's range: 99% at R 0.40, 97% at 0.45, 96% at 0.50, 92% at 0.60. The
    two bench measurements (R 0.427, 0.433) now read 98%.
    spo2_from_ratio() now holds R at the curve's turning point for ei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
2026-11-10 Firmware: interim SpO2 calibration for the resting range
    Both published curves show 100% at rest on this band: it reads R
    0.32-0.52 across sessions (the spread comes from how the board sits),
    and Maxim's MAX30101 curve passes 100% below R 0.37. With no reference
    oximeter available, use an interim line, SpO2 = 102.8 - 15 R, which maps
    that resting range onto the normal 95-98% (R 0.33 -> 98%, 0.43 -> 96%,
    0.52 -> 95%).
    The line is flatter than a real calibration, so a pooled R of 1.0 or more
    (red and IR swinging by the same fraction: the band moving on the skin)
    is now rejected as an unstable signal regardless of the curve, keeping
    the cut-off the published curves gave at about 80%.
    app_conf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
    [app_config.h, spo2.c, spo2.h]
2026-11-11 Firmware: turn SpO2 bench mode off for delivery
    Back to the client's sampling plan: the first check about 2 min after
    power-up, then every 30 min while worn, 5 min after a failed attempt.
    Bench mode measured back to back every 10 s, keeping the red LED lit
    most of the time.
    [app_config.h]
2026-11-11 Firmware: accept reminder intervals of 15 minutes or more
    The band has no pairing, so anyone nearby can write the intervals, and
    they are kept in flash. A write of 1 minute left the band buzzing every
    minute, through power cycles, until an app wrote them again. The app
    offers 20-60 minutes, so 15 is now the floor; a lower write is rejected
    and a lower value already in flash loads as the default.
    [app_config.h, band_mode.h]
2026-11-11 Firmware: hold one lock around every flash storage access
    The data log is written on its own thread and read on the BLE thread
    during a sync, and settings are saved from the main loop, all in the
    same NVS. NVS serializes writes but not reads, so a read could walk a
    sector that a write was erasing for garbage collection and report a
    record missing; the sync then skipped it, and the app never asked for
    it again.
    storage.c now has a mutex (with priority inheritance, so the low-
    priority writer cannot hold up the main loop for longer than one NVS
    write) taken by storage_load(), storage_save() and every direct NVS call
    in data_log.c.
    [data_log.c, storage.c, storage.h]
2026-11-11 Firmware: retry turning the SpO2 red LED off if the write fails
    A measurement ends by setting the red LED current to 0. If that I2C write
    failed, the LED stayed lit at up to 51 mA until the next measurement
    turned it on and off again, which is 5-30 min in normal use. The write is
    now retried every second until it succeeds. A band whose sensor never
    started skips it, since the LED was never lit.
    [spo2.c]
2026-11-11 Firmware: name the band in the Device Information Service
    A phone's Bluetooth settings or a BLE scanner showed Zephyr's
    placeholders: manufacturer "Manufacturer", model number the SoC name,
    and a PnP ID with vendor 0. Report "Umbra" and "Umbra Band" (the
    non-deprecated _STR options of Zephyr 4.3) and drop the PnP ID.
    Also correct a prj.conf comment: a 247-byte MTU carries 12 log records
    per notification, not 15.
2026-11-11 Firmware: run the I2C bus at 400 kHz
    The MAX30101 and BMI270 both support fast mode, and the PCB has 4.7k
    pull-ups on SDA and SCL. At 100 kHz the bus was busy for about 80 ms of
    every second draining the sensor FIFO, with the TWIM and the high-
    frequency clock on throughout; at 400 kHz each transfer takes a quarter
    of the time, and the BMI270 firmware load at start-up drops from about
    1 s to about 0.5 s.
2026-11-11 Firmware: read the MAX30101 FIFO in one burst per drain
    Each sample went through the Zephyr driver's sensor_sample_fetch(): one
    I2C transfer of 6 bytes, plus two sensor_channel_get() calls, 100 times
    a second. The wrapper already read the FIFO pointers itself; it now
    reads every waiting sample (up to 32 x 6 = 192 bytes, within one TWIM
    transfer) in a single burst and unpacks red and IR, as the driver did:
    3 bytes each, big endian, masked to 18 bits. The driver still configures
    the sensor at boot, and the build-time checks on its slots, rate and
    pulse width are unchanged.
    That is about 25 transfers a second instead of 100, so less bus time,
    fewer interrupts and less CPU time per FIFO drain.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
2026-11-11 Firmware: correct the transfer count in the FIFO read comments
    With the pointer read, a drain is two transfers, not one.
    [max30101.c]
2026-11-11 Firmware: advertise slowly once nobody has connected for 30 s
    The band advertised every 100-150 ms whenever no phone was connected,
    which is most of the time. It now does that for 30 s after start-up and
    after each disconnect, so an app that is waiting reconnects at once,
    then every 1022.5 ms (an interval Apple recommends for accessories)
    until a phone connects: about a tenth of the advertising current. The
    advertising retry after a failure keeps working in both phases.
    [ble_service.c]
2026-11-11 Firmware: version 1.2.0 for delivery, with a delivery checklist
    1.2.0 is the first build for the client: bench mode off, the log resend,
    the 15-minute interval floor, the storage lock, the red LED retry, the
    Device Information names, 400 kHz I2C, burst FIFO reads and slow
    advertising. The flash layout is unchanged from 1.1.0.
    The README gets a short checklist for preparing a unit (bench mode,
    version, full erase, VDD check, battery reading, power switch), and
    BLE_INTERFACE.md lists what changed for the app since 1.1.0.
